RU09342-F18/intro-to-embedded-final-project-russells-muscle/(commit log)

2018-12-09 Working Sensors
2018-12-19 added button stuff to ESP desccription
